ole00/niceprog/img/niceprog_rev1_assembled.jpg

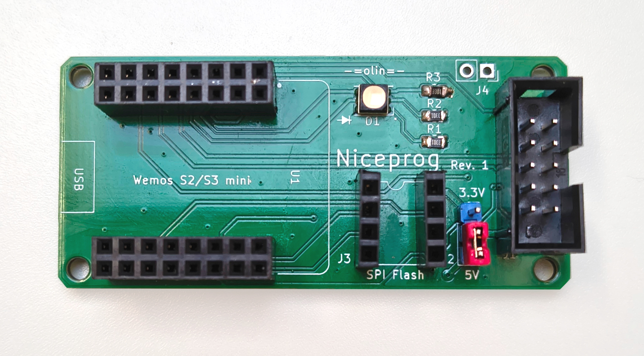
img/niceprog_rev1_assembled.jpg
