ole00/niceprog/design/niceprog_olimex_ice40_evb.pdf

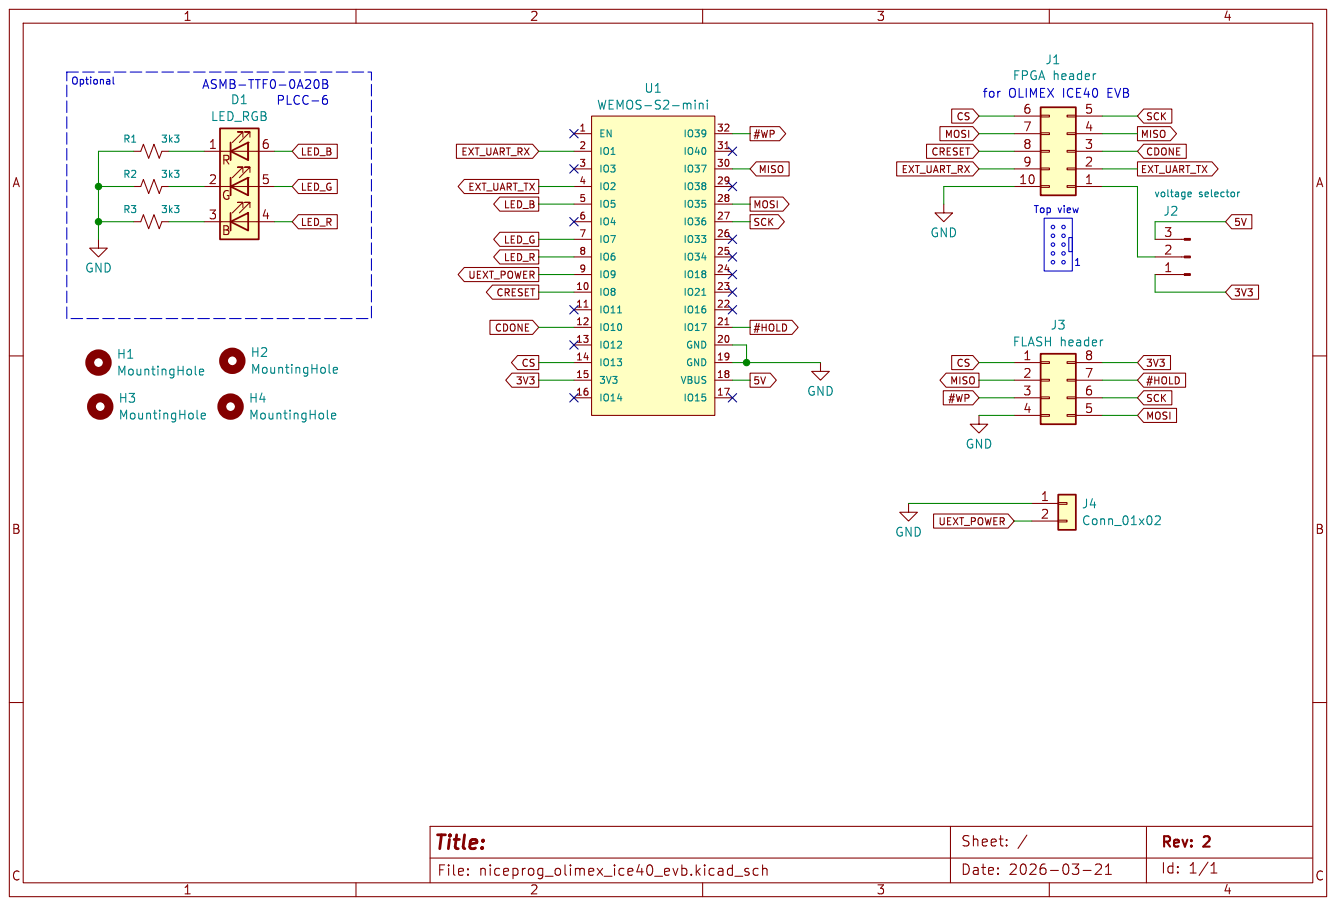
[picture p6: page 1]
