ole00/niceprog/src/crc16.c

/**
 * \file new_crc.c
 * Functions and types for CRC checks.
 *
 * Generated on Wed Mar 11 21:00:17 2026,
 * by pycrc v0.7.10, http://www.tty1.net/pycrc/
 * using the configuration:
 *    Width        = 16
 *    Poly         = 0x8005
 *    XorIn        = 0x0000
 *    ReflectIn    = True
 *    XorOut       = 0x0000
 *    ReflectOut   = True
 *    Algorithm    = bit-by-bit-fast
 *****************************************************************************/
#include "crc16.h"     /* include the header file generated with pycrc */
#include <stdlib.h>
#include <stdint.h>
#include <stdbool.h>

/**
 * Reflect all bits of a \a data word of \a data_len bytes.
 *
 * \param data         The data word to be reflected.
 * \param data_len     The width of \a data expressed in number of bits.
 * \return             The reflected data.
 *****************************************************************************/
crc_t crc_reflect(crc_t data, size_t data_len)
{
    unsigned int i;
    crc_t ret;

    ret = data & 0x01;
    for (i = 1; i < data_len; i++) {
        data >>= 1;
        ret = (ret << 1) | (data & 0x01);
    }
    return ret;
}


/**
 * Update the crc value with new data.
 *
 * \param crc      The current crc value.
 * \param data     Pointer to a buffer of \a data_len bytes.
 * \param data_len Number of bytes in the \a data buffer.
 * \return         The updated crc value.
 *****************************************************************************/
crc_t crc_update(crc_t crc, const unsigned char *data, size_t data_len)
{
    unsigned int i;
    bool bit;
    unsigned char c;

    while (data_len--) {
        c = *data++;
        for (i = 0x01; i & 0xff; i <<= 1) {
            bit = crc & 0x8000;
            if (c & i) {
                bit = !bit;
            }
            crc <<= 1;
            if (bit) {
                crc ^= 0x8005;
            }
        }
        crc &= 0xffff;
    }
    return crc & 0xffff;
}
