ole00/niceprog/(commit log)

2026-03-19 version 1.0: arduino sketch and pc_app sources
2026-03-22 version 1.2 - improved memory handling and added support for ESP32-S3
2026-04-05 fixed ESP32-S3 USB CDC Serial - must use USB-OTG(TinyUSB) mode
    ESP32-S3 could not use HARDWARE CDC as it could not cope with
    fast serial port ransfers.
    When building niceprog for ESP32-S3 ensure the USB Mode is set
    to USB-OTG(TinyUSB) to work properly.
    Note that ESP32-S2 can work with HARDWARE CDC fine. No need to use
    USB-OTG(TinyUsb) mode.
    [niceprog.ino]
2026-04-05 PC App: improved handling of stalled transfers
2026-04-05 PC App: added some verbose printouts
2026-04-09 fixed PIN_CS being set as output in idle mode
    That might have prevented FPGA chip to drive the pin low
    when attempting to read the bit stream from flash in some cases.
    [niceprog.ino]
2026-04-09 added gerbers for niceprog PCB
2026-04-09 added PCB kicad design files and .pdf schematic
2026-04-09 added arduino ide configuration screenshots
2026-04-10 sketch: added missing new lines to debug output
    [niceprog.ino]
2026-04-10 PC App: fixed serial connection parameters
    Windows OS requires DTR and RTS control enabled to be able to
    read data from USB CDC serial ports.
    [serial_port.h]
2026-04-11 img: added wiring diagram
2026-04-11 Updated README.md - added a direct wiring diagram
